TimKong21/Voice-Commander-System/schematics/V-Map Command Interpreter Schematic.JPG

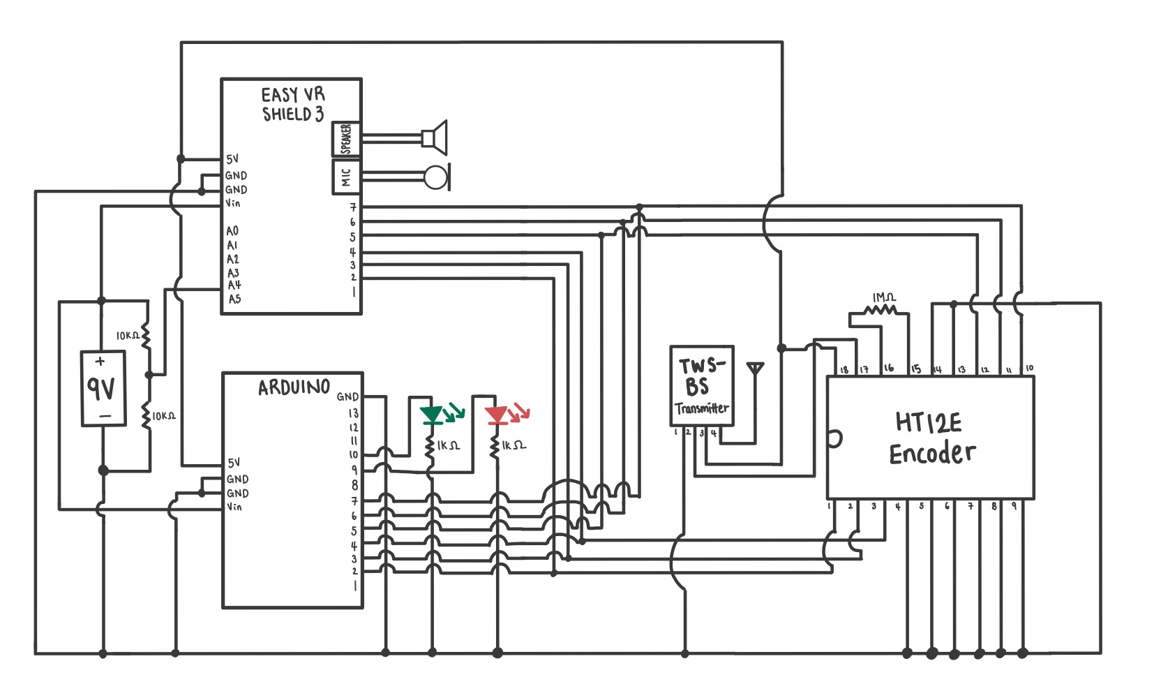
schematics/V-Map Command Interpreter Schematic.JPG
