TimKong21/Voice-Commander-System/schematics/V-Map Receiving Switch Schematic.JPG

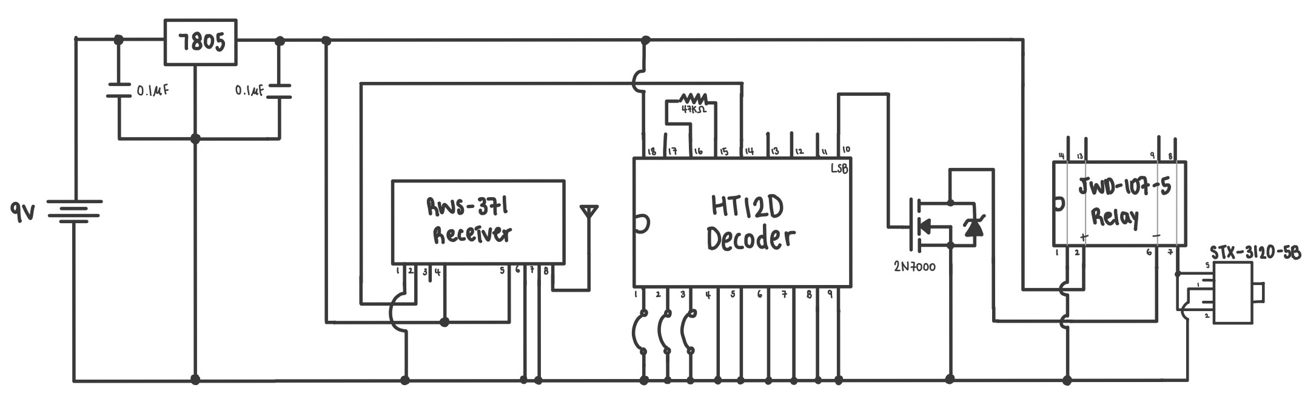
schematics/V-Map Receiving Switch Schematic.JPG
